Ghost-Girls/PMW3360-3389-PAW3395_STM32-CH32-APM32/Circuit/SCH/stm32f042_pmw3360.jpg

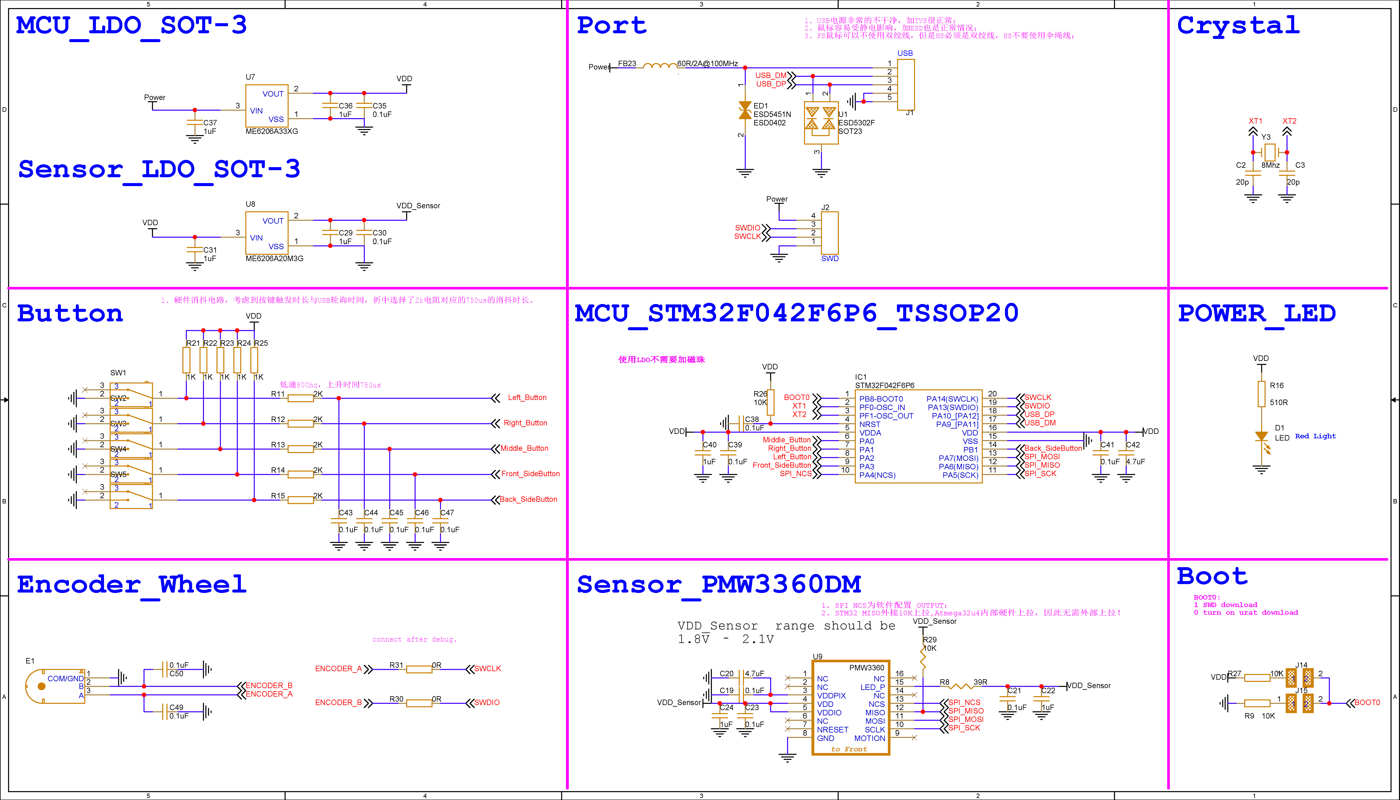
Circuit/SCH/stm32f042_pmw3360.jpg
