Ghost-Girls/PMW3360-3389-PAW3395_STM32-CH32-APM32/Code/file-游戏鼠标代码解析（一）（A站唯一指定 ID：Ghost-Girls）.png

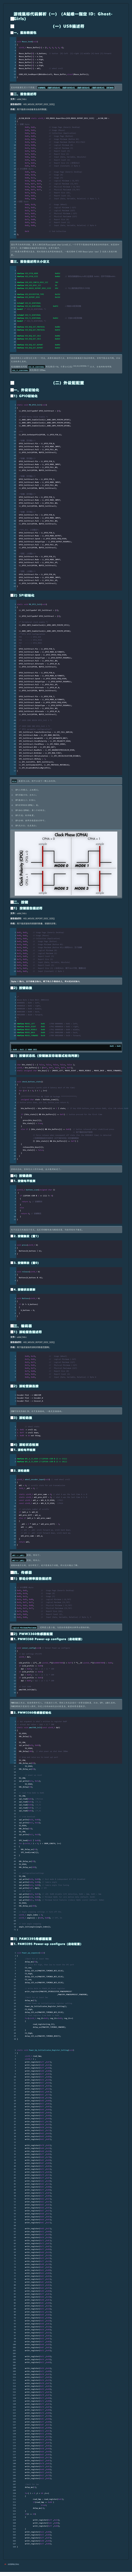
Code/file-游戏鼠标代码解析（一）（A站唯一指定 ID：Ghost-Girls）.png
