Ghost-Girls/PMW3360-3389-PAW3395_STM32-CH32-APM32/Circuit/SCH/stm32f042_pmw3360.pdf

# MCU_LDO_SOT-3

# Sensor_LDO_SOT-3

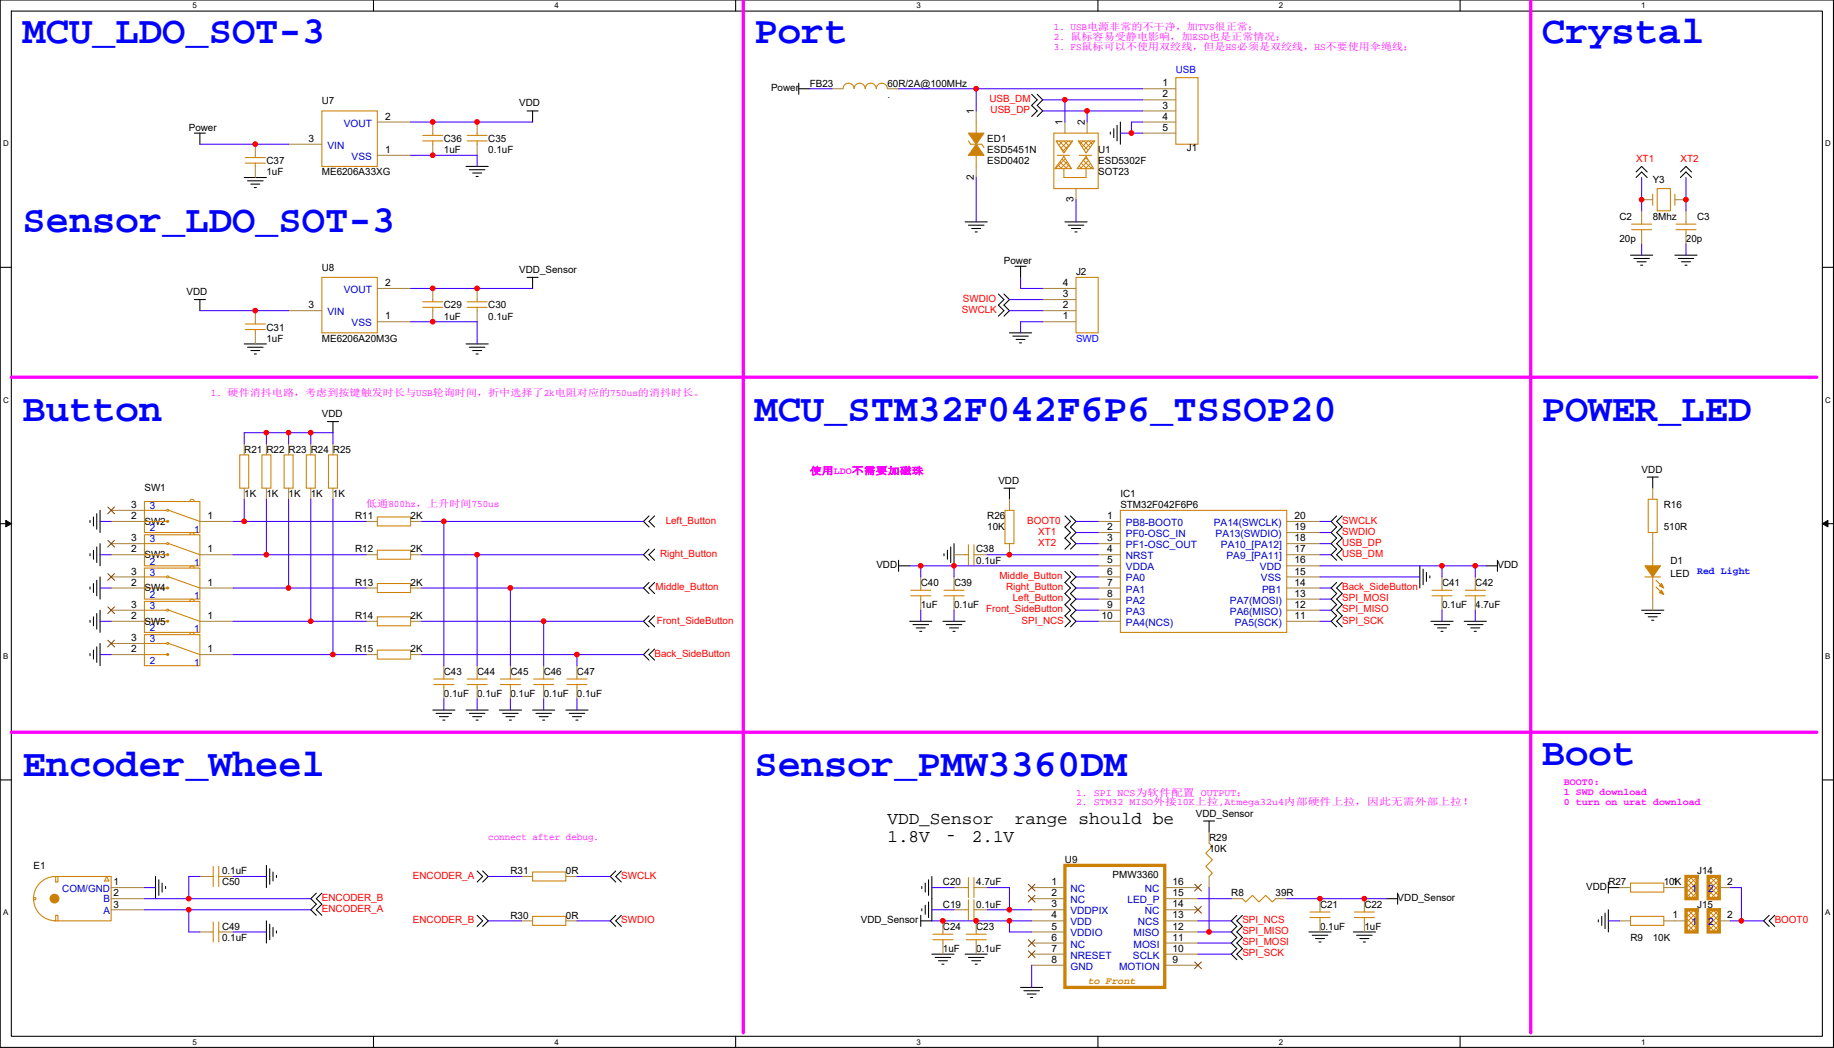
[picture p5: page 1]

BOOT0:
1 SWD download
0 turn on urat download
