Ghost-Girls/PMW3360-3389-PAW3395_STM32-CH32-APM32/(list of files, drawings)

Other design files:
Circuit/SCH/stm32f042_pmw3360.DSN
