Ghost-Girls/PMW3360-3389-PAW3395_STM32-CH32-APM32/(threads)

Thread 1 (2023-07-16):

您好，请问paw3395的库和寄存器列表在哪里呢？我没有在项目中找到？

lyb36524, 2023-07-16:
您好，请问paw3395的库和寄存器列表在哪里呢？我没有在项目中找到？

nikitalita, 2024-04-21:
@lyb36524  https://github.com/ALpotato/zmk/blob/ptdevice-alpotato/app/drivers/sensor/pixart/paw3395/paw3395_priv.c

Closed 2023-12-17.
