Ghost-Girls/PMW3360-3389-PAW3395_STM32-CH32-APM32/Code/Inc/srom_3360_0x04.h

#define SROM_LENGTH (4094)
//const uint16_t srom[SROM_LENGTH] =
const unsigned char srom[SROM_LENGTH] =
{
0x01,
0x03,
0x87,
0x8a,
0x56,
0x0f,
0xde,
0x3e,
0xfe,
0x5f,
0x1d,
0xb8,
0xf2,
0x66,
0x4e,
0xff,
0x7c,
0x7a,
0x76,
0x4e,
0x1c,
0xb8,
0xd7,
0x0d,
0x79,
0x70,
0x62,
0x27,
0xcc,
0x1a,
0xb6,
0xee,
0x3f,
0xfc,
0x7a,
0x76,
0x4f,
0x1c,
0x9b,
0xb4,
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
};
