Ghost-Girls/PMW3360-3389-PAW3395_STM32-CH32-APM32/(notices)

Notices in the files:
Code/Src/main.c:
Copyright (c) 2023 STMicroelectronics.
All rights reserved.
This software is licensed under terms that can be found in the LICENSE file
